flpvsk/glagol/ms20verb.kicad_pcb

## KiCad design ms20verb.kicad_pcb (2021-09-10)

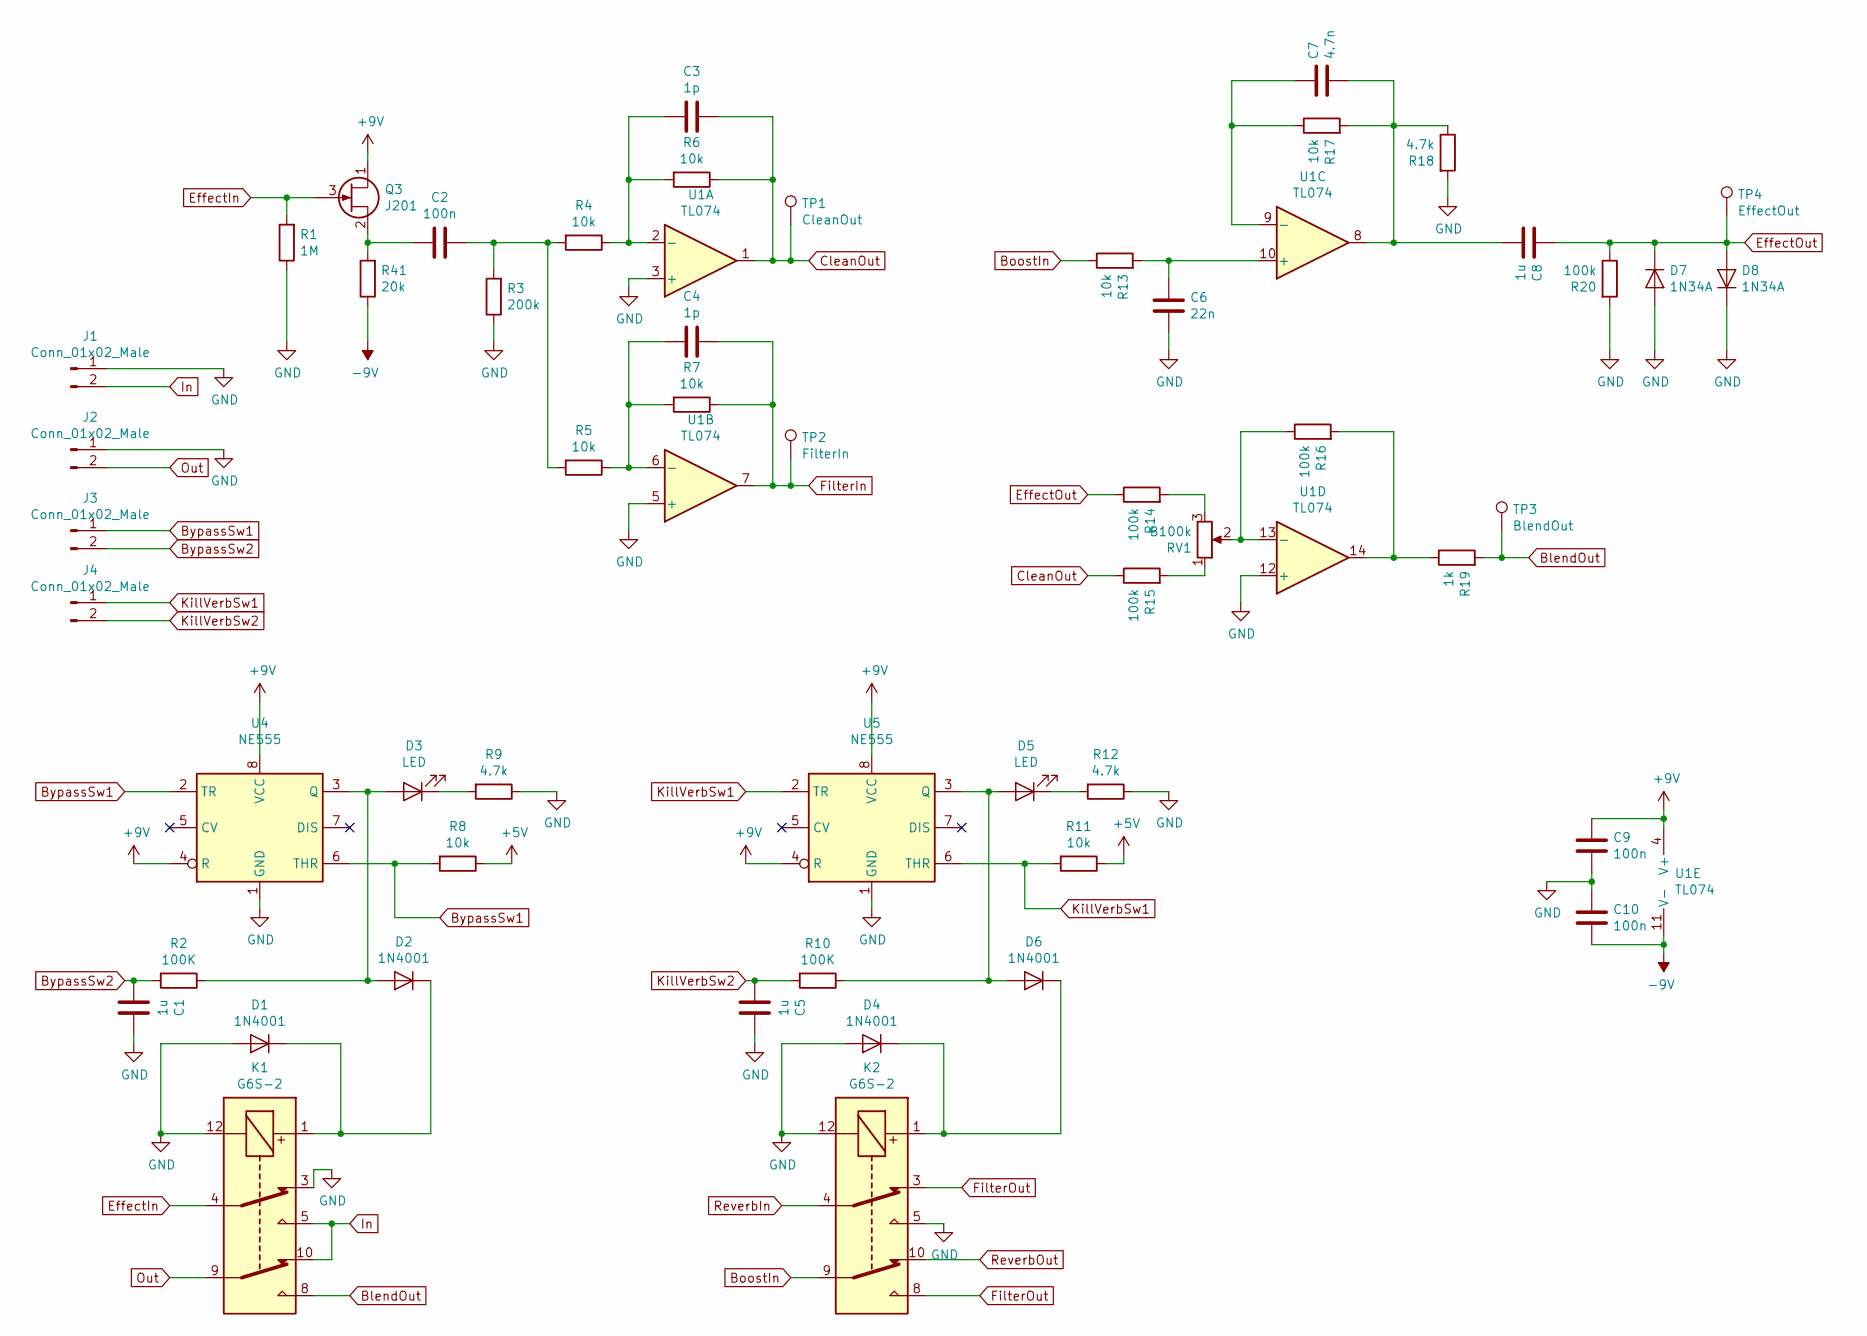
[picture p5: schematic Sheet1.sch, Ping]

Parts:
C1, C5, C8: 1u; C_Rect_L7.0mm_W4.5mm_P5.00mm
C2, C9, C10: 100n; C_Rect_L7.0mm_W2.5mm_P5.00mm
C3, C4: 1p; C_Disc_D4.7mm_W2.5mm_P5.00mm
C6: 22n; C_Disc_D5.1mm_W3.2mm_P5.00mm
C7: 4.7n; C_Disc_D5.1mm_W3.2mm_P5.00mm
D1, D2, D4, D6: 1N4001; D_DO-41_SOD81_P10.16mm_Horizontal
D3, D5: LED; LED_D5.0mm
D7, D8: 1N34A; D_DO-41_SOD81_P10.16mm_Horizontal
J1, J2, J3, J4: Conn_01x02_Male; JST_XH_B2B-XH-A_1x02_P2.50mm_Vertical
K1, K2: G6S-2; 8-PIN_Fujitsu_Tayda
Q3: J201; TO-92L_Inline_Wide
R1: 1M; R_0603_1608Metric_Pad1.05x0.95mm_HandSolder
R2, R10: 100K; R_0603_1608Metric_Pad1.05x0.95mm_HandSolder
R3: 200k; R_0603_1608Metric_Pad1.05x0.95mm_HandSolder
R4, R5, R6, R7, R8, R11, R13, R17: 10k; R_0603_1608Metric_Pad1.05x0.95mm_HandSolder
R9, R12, R18: 4.7k; R_0603_1608Metric_Pad1.05x0.95mm_HandSolder
R14, R15, R16, R20: 100k; R_0603_1608Metric_Pad1.05x0.95mm_HandSolder
R19: 1k; R_0603_1608Metric_Pad1.05x0.95mm_HandSolder
R41: 20k; R_0603_1608Metric_Pad1.05x0.95mm_HandSolder
RV1: B100k; 16MM_B.MOUNT_BANZAI
TP1: CleanOut; TestPoint_THTPad_D1.5mm_Drill0.7mm
TP2: FilterIn; TestPoint_THTPad_D1.5mm_Drill0.7mm
TP3: BlendOut; TestPoint_THTPad_D1.5mm_Drill0.7mm
TP4: EffectOut; TestPoint_THTPad_D1.5mm_Drill0.7mm
U1: TL074; DIP-14_W7.62mm
U4, U5: NE555; DIP-8_W7.62mm

Connections:
+5V: R8.1, R11.1; also elsewhere on the board
+9V: C9.1, Q3.1 (D), U1.4 (V+), U4.4 (R), U4.8 (VCC), U5.4 (R), U5.8 (VCC); also elsewhere on the board
-9V: C10.2, R41.1, U1.11 (V-); also elsewhere on the board
BlendOut: K1.8, R19.2, TP3.1
BoostIn: K2.9, R13.1
BypassSw1: J3.1, R8.2, U4.2 (TR), U4.6 (THR)
BypassSw2: C1.2, J3.2, R2.2
CleanOut: C3.1, R6.1, R15.1, TP1.1, U1.1
EffectIn: K1.4, Q3.3 (G), R1.2
EffectOut: C8.2, D7.1 (K), D8.2 (A), R14.1, R20.1, TP4.1
FilterIn: C4.1, R7.1, TP2.1, U1.7; also elsewhere on the board
FilterOut: K2.3, K2.8; also elsewhere on the board
GND: C1.1, C5.1, C6.1, C9.2, C10.1, D1.2 (A), D4.2 (A), D7.2 (A), D8.1 (K), J1.1, J2.1, K1.3, K1.12, K2.5, K2.12, R1.1, R3.1, R9.1, R12.1, R18.2, R20.2, U1.3 (+), U1.5 (+), U1.12 (+), U4.1 (GND), U5.1 (GND); also elsewhere on the board
In: J1.2, K1.5, K1.10
KillVerbSw1: J4.1, R11.2, U5.2 (TR), U5.6 (THR)
KillVerbSw2: C5.2, J4.2, R10.2
unnamed: C2.1, R3.2, R4.2, R5.2
unnamed: C2.2, Q3.2 (S), R41.2
unnamed: C3.2, R4.1, R6.2, U1.2 (-)
unnamed: C4.2, R5.1, R7.2, U1.6 (-)
unnamed: C6.2, R13.2, U1.10 (+)
unnamed: C7.1, C8.1, R17.2, R18.1, U1.8
unnamed: C7.2, R17.1, U1.9 (-)
unnamed: D1.1 (K), D2.1 (K), K1.1
unnamed: D2.2 (A), D3.2 (A), R2.1, U4.3 (Q)
unnamed: D3.1 (K), R9.2
unnamed: D4.1 (K), D6.1 (K), K2.1
unnamed: D5.1 (K), R12.2
unnamed: D5.2 (A), D6.2 (A), R10.1, U5.3 (Q)
unnamed: R14.2, RV1.3
unnamed: R15.2, RV1.1
unnamed: R16.1, RV1.2, U1.13 (-)
unnamed: R16.2, R19.1, U1.14
Out: J2.2, K1.9
ReverbIn: K2.4; also elsewhere on the board
ReverbOut: K2.10; also elsewhere on the board

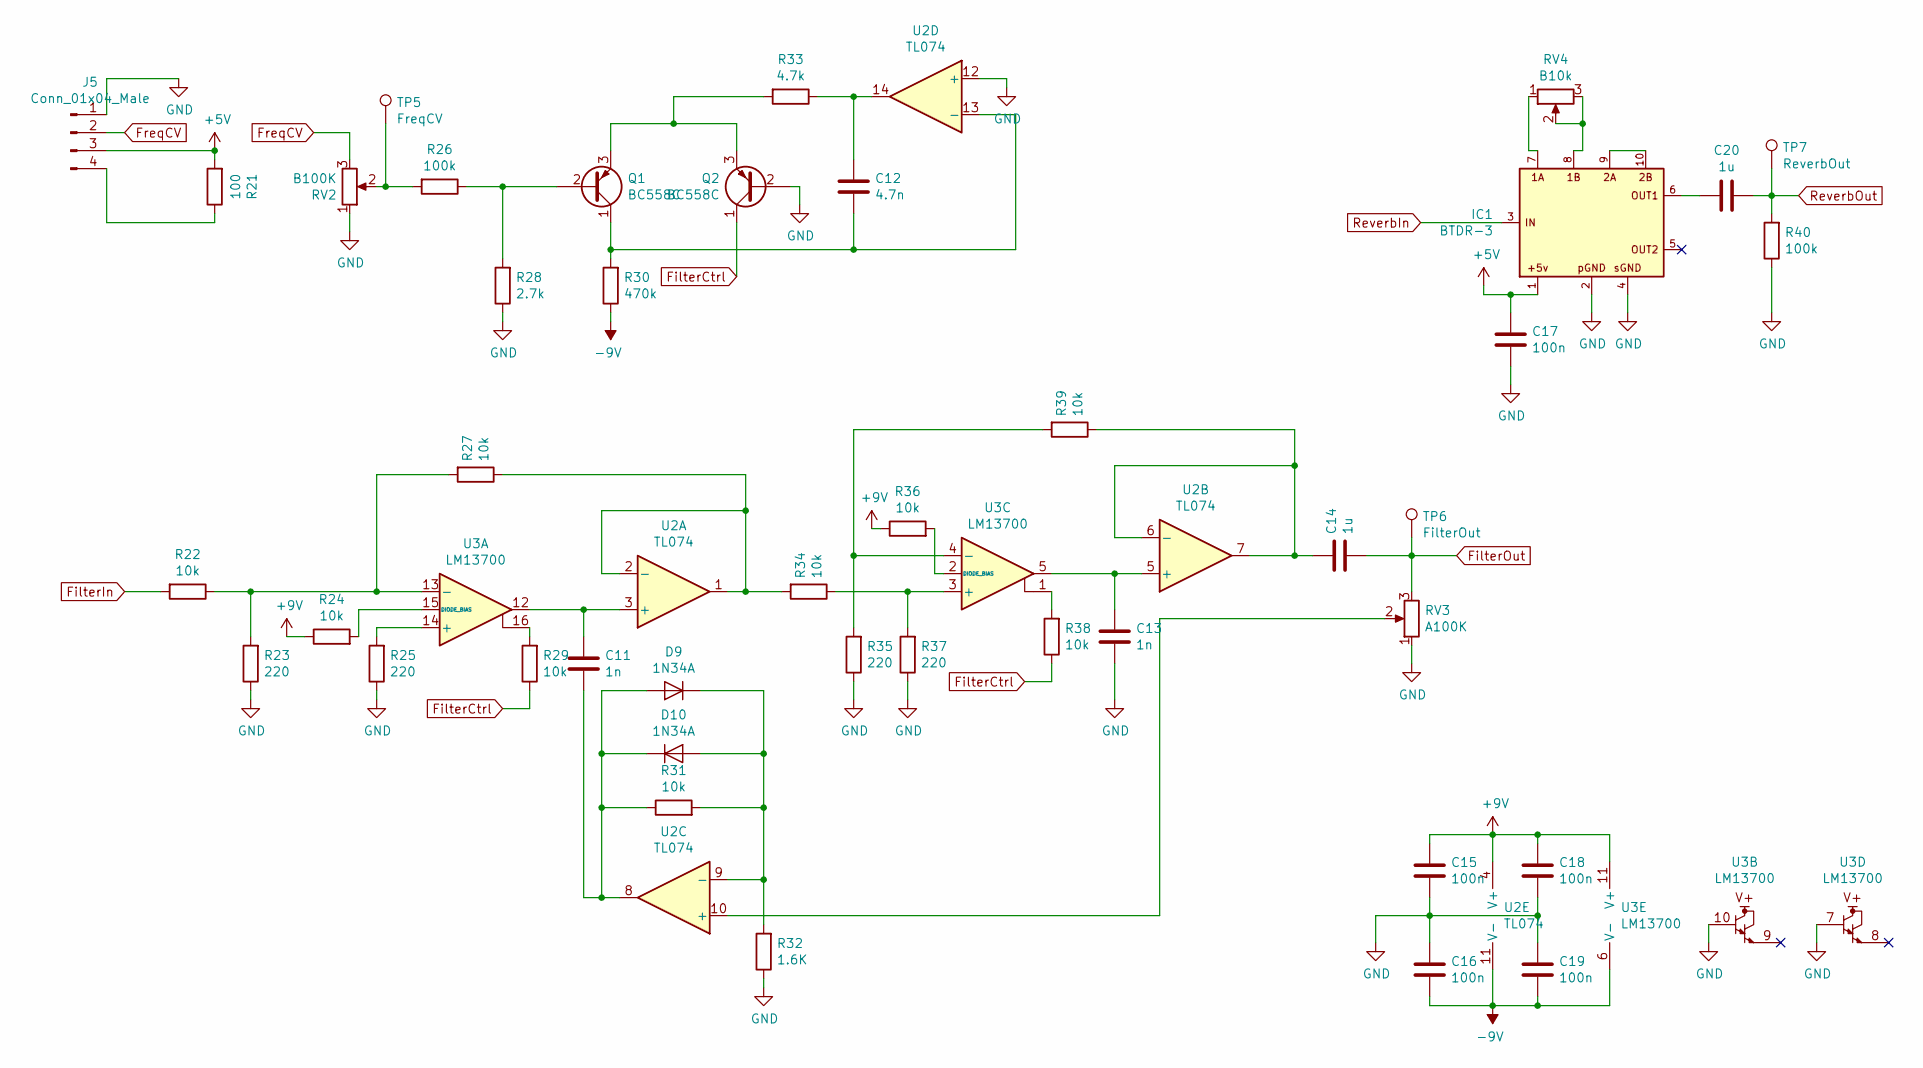
[picture p6: schematic Sheet2.sch, Ping]

Parts:
C11, C13: 1n; C_Disc_D5.1mm_W3.2mm_P5.00mm
C12: 4.7n; C_Disc_D5.1mm_W3.2mm_P5.00mm
C14, C20: 1u; C_Rect_L7.0mm_W4.5mm_P5.00mm
C15, C16, C17, C18, C19: 100n; C_Rect_L7.0mm_W2.5mm_P5.00mm
D9, D10: 1N34A; D_DO-41_SOD81_P10.16mm_Horizontal
IC1: BTDR-3
J5: Conn_01x04_Male; JST_XH_B4B-XH-A_1x04_P2.50mm_Vertical
Q1, Q2: BC558C; TO-92L_Inline_Wide
R21: 100; R_0603_1608Metric_Pad1.05x0.95mm_HandSolder
R22, R24, R27, R29, R31, R34, R36, R38, R39: 10k; R_0603_1608Metric_Pad1.05x0.95mm_HandSolder
R23, R25, R35, R37: 220; R_0603_1608Metric_Pad1.05x0.95mm_HandSolder
R26, R40: 100k; R_0603_1608Metric_Pad1.05x0.95mm_HandSolder
R28: 2.7k; R_0603_1608Metric_Pad1.05x0.95mm_HandSolder
R30: 470k; R_0603_1608Metric_Pad1.05x0.95mm_HandSolder
R32: 1.6K; R_0603_1608Metric_Pad1.05x0.95mm_HandSolder
R33: 4.7k; R_0603_1608Metric_Pad1.05x0.95mm_HandSolder
RV2: B100K; 16MM_B.MOUNT_BANZAI
RV3: A100K; 16MM_B.MOUNT_BANZAI
RV4: B10k; 16MM_B.MOUNT_BANZAI
TP5: FreqCV; TestPoint_THTPad_D1.5mm_Drill0.7mm
TP6: FilterOut; TestPoint_THTPad_D1.5mm_Drill0.7mm
TP7: ReverbOut; TestPoint_THTPad_D1.5mm_Drill0.7mm
U2: TL074; DIP-14_W7.62mm
U3: LM13700; DIP-16_W7.62mm

Connections:
+5V: C17.1, IC1.1, J5.3, R21.2; also elsewhere on the board
+9V: C15.1, C18.1, R24.1, R36.1, U2.4 (V+), U3.11 (V+); also elsewhere on the board
-9V: C16.2, C19.2, R30.1, U2.11 (V-), U3.6 (V-); also elsewhere on the board
FilterCtrl: Q2.1 (C), R29.1, R38.1
FilterIn: R22.2; also elsewhere on the board
FilterOut: C14.1, RV3.3, TP6.1; also elsewhere on the board
FreqCV: J5.2, RV2.3
GND: C13.1, C15.2, C16.1, C17.2, C18.2, C19.1, IC1.2, IC1.4, J5.1, Q2.2 (B), R23.1, R25.1, R28.1, R32.1, R35.1, R37.1, R40.1, RV2.1, RV3.1, U2.12 (+), U3.7, U3.10; also elsewhere on the board
unnamed: C11.1, D9.2 (A), D10.1 (K), R31.1, U2.8
unnamed: C11.2, U2.3 (+), U3.12
unnamed: C12.1, Q1.1 (C), R30.2, U2.13 (-)
unnamed: C12.2, R33.1, U2.14
unnamed: C13.2, U2.5 (+), U3.5
unnamed: C14.2, R39.1, U2.6 (-), U2.7
unnamed: C20.2, IC1.6
unnamed: D9.1 (K), D10.2 (A), R31.2, R32.2, U2.9 (-)
unnamed: IC1.7, RV4.1
unnamed: IC1.8, RV4.2, RV4.3
unnamed: IC1.9, IC1.10
unnamed: J5.4, R21.1
unnamed: Q1.2 (B), R26.1, R28.2
unnamed: Q1.3 (E), Q2.3 (E), R33.2
unnamed: R22.1, R23.2, R27.2, U3.13 (-)
unnamed: R24.2, U3.15 (DIODE_BIAS)
unnamed: R25.2, U3.14 (+)
unnamed: R26.2, RV2.2, TP5.1
unnamed: R27.1, R34.2, U2.1, U2.2 (-)
unnamed: R29.2, U3.16
unnamed: R34.1, R37.2, U3.3 (+)
unnamed: R35.2, R39.2, U3.4 (-)
unnamed: R36.2, U3.2 (DIODE_BIAS)
unnamed: R38.2, U3.1
unnamed: RV3.2, U2.10 (+)
ReverbIn: IC1.3; also elsewhere on the board
ReverbOut: C20.1, R40.2, TP7.1; also elsewhere on the board

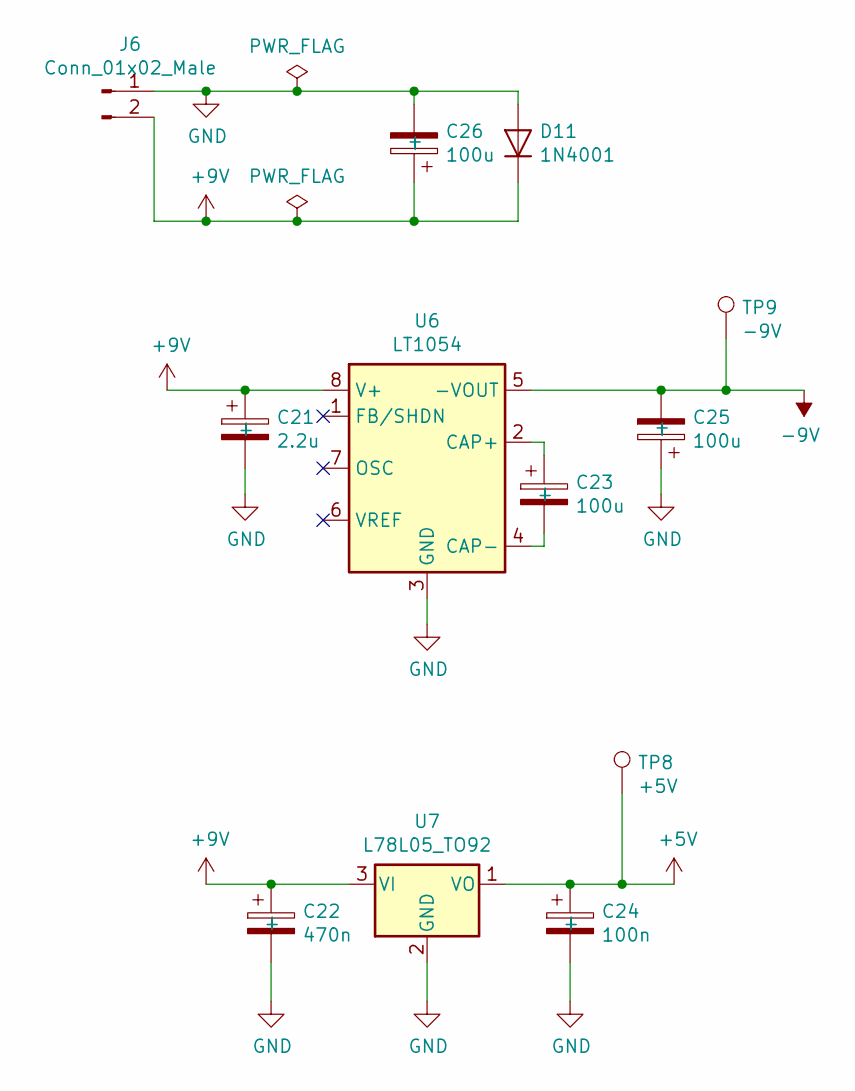
[picture p7: schematic Sheet3.sch, Ping]

Parts:
C21: 2.2u; CP_Radial_D5.0mm_P2.00mm
C22: 470n; CP_Radial_D5.0mm_P2.00mm
C23, C25, C26: 100u; CP_Radial_D5.0mm_P2.50mm
C24: 100n; CP_Radial_D5.0mm_P2.00mm
D11: 1N4001; D_DO-41_SOD81_P10.16mm_Horizontal
J6: Conn_01x02_Male; JST_XH_B2B-XH-A_1x02_P2.50mm_Vertical
TP8: +5V; TestPoint_THTPad_D1.5mm_Drill0.7mm
TP9: -9V; TestPoint_THTPad_D1.5mm_Drill0.7mm
U6: LT1054; DIP-8_W7.62mm
U7: L78L05_TO92; TO-92_Inline

Connections:
+5V: C24.1 (+), TP8.1, U7.1 (VO); also elsewhere on the board
+9V: C21.1 (+), C22.1 (+), C26.1 (+), D11.1 (K), J6.2, U6.8 (V+), U7.3 (VI); also elsewhere on the board
-9V: C25.2 (-), TP9.1, U6.5 (-VOUT); also elsewhere on the board
GND: C21.2 (-), C22.2 (-), C24.2 (-), C25.1 (+), C26.2 (-), D11.2 (A), J6.1, U6.3 (GND), U7.2 (GND); also elsewhere on the board
unnamed: C23.1 (+), U6.2 (CAP+)
unnamed: C23.2 (-), U6.4 (CAP-)

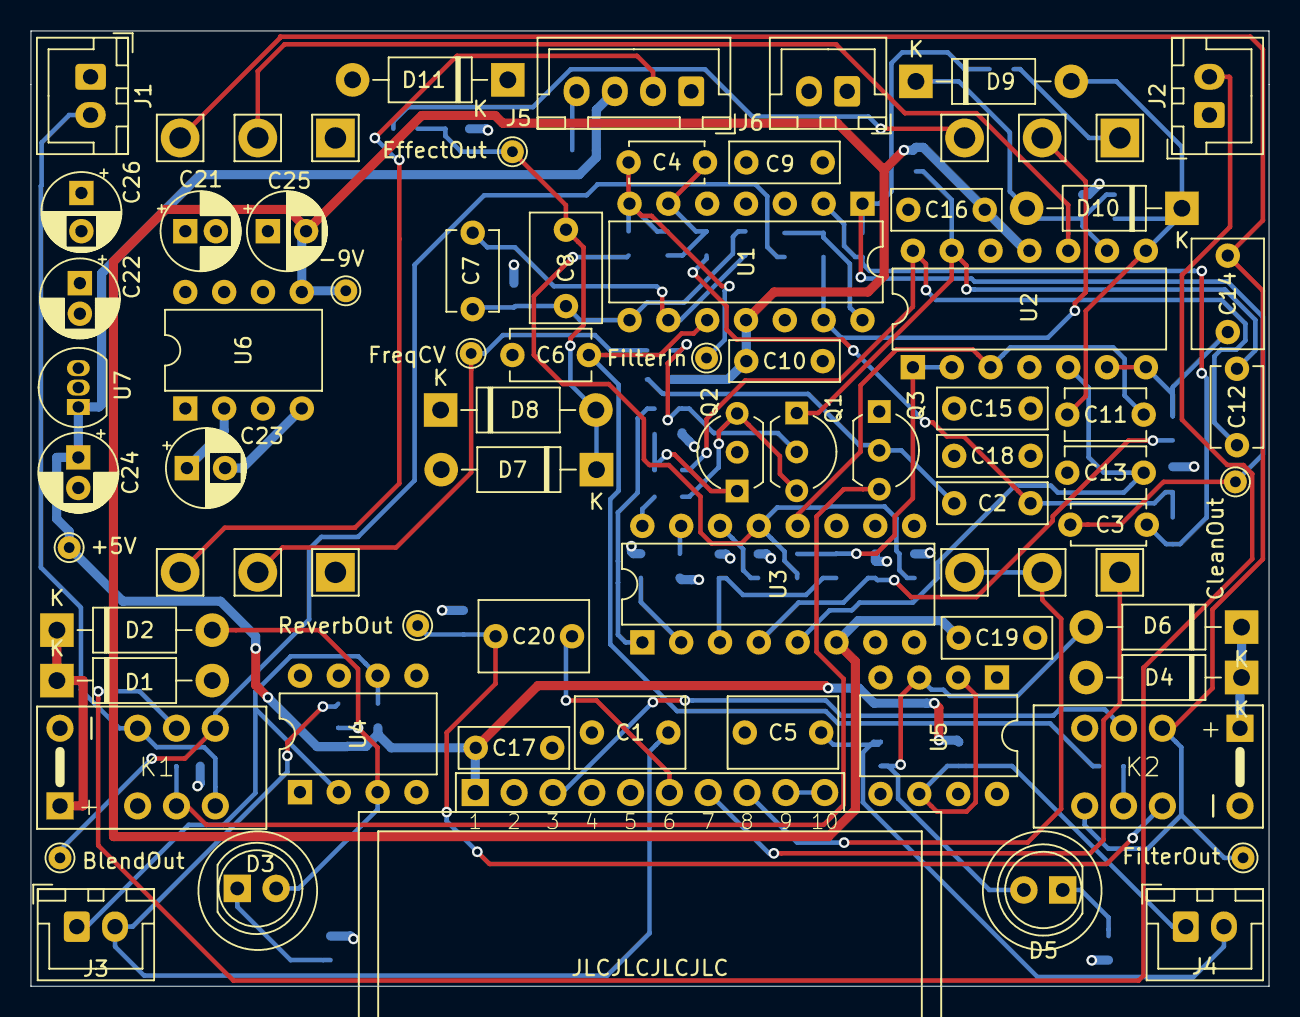
[picture p8: board ms20verb.kicad_pcb from above]

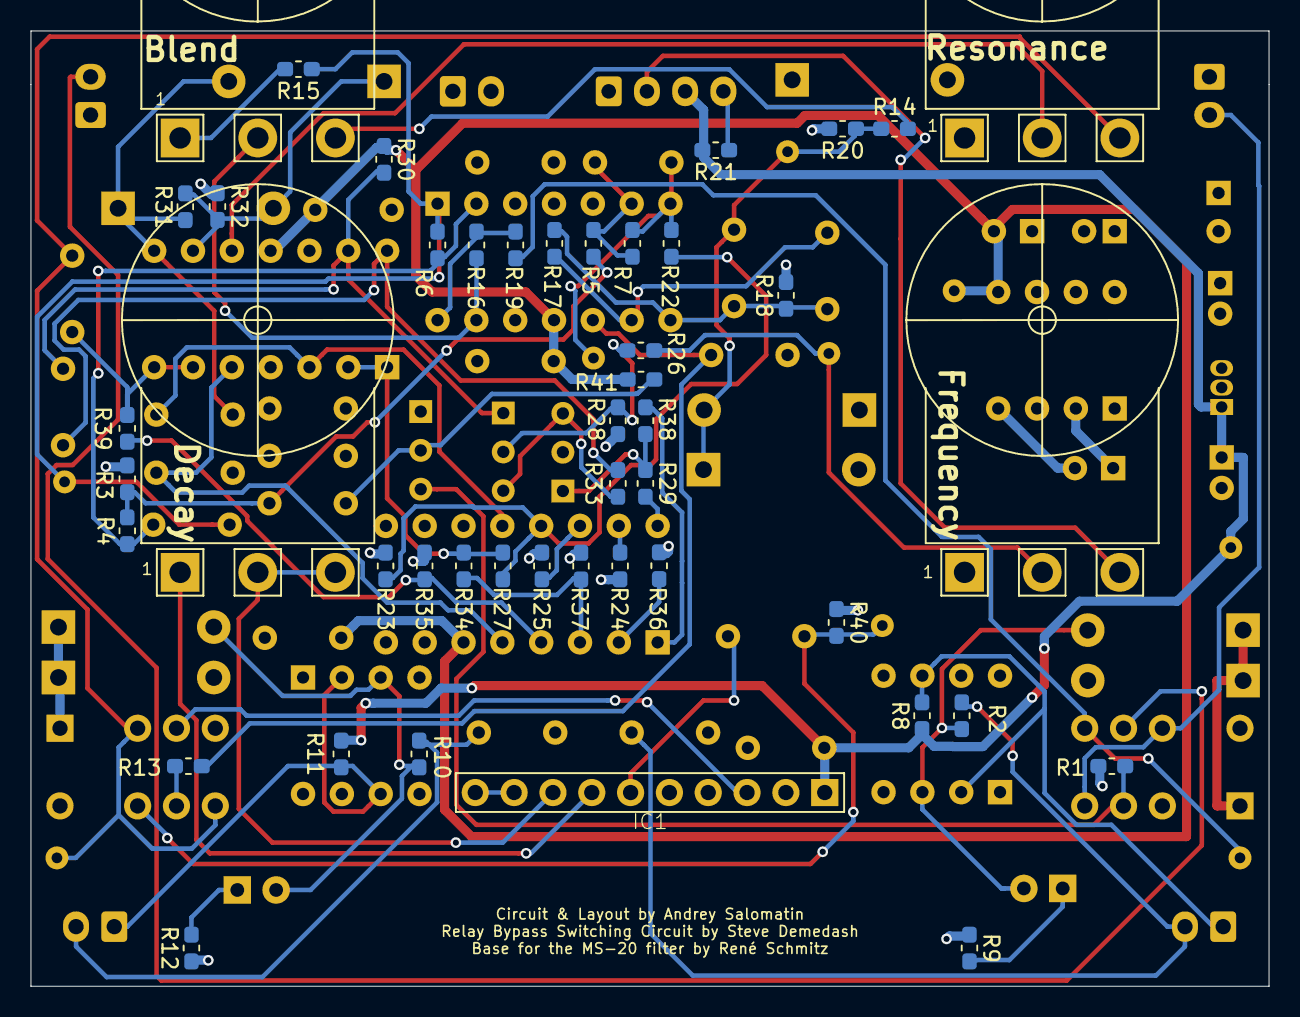
[picture p9: board ms20verb.kicad_pcb from below]

Board: 4 copper layers, 81.0 x 62.5 mm, 113 parts (41 on the bottom side), 65 nets.

Other parts of the board:
Ref**: Val**; MOMENTARY
Ref**#2: Val**; MOMENTARY
Ref**#3: Val**; DC_TOP
