flpvsk/glagol/(commit log)

2021-08-14 TH version
    [Sheet1.sch, Sheet2.sch, Sheet3.sch, ms20verb.kicad_pcb, ms20verb.sch]
2021-08-14 Resistors to SMD
    [Sheet1.sch, Sheet2.sch, ms20verb.kicad_pcb]
2021-08-19 2 layer dead end
    [Sheet1.sch, ms20verb.kicad_pcb]
2021-08-19 4-layer board finished
    [ms20verb.kicad_pcb]
2021-08-22 Hand-solder 0603 resistors
    [ms20verb.kicad_pcb]
2021-09-10 v1 sent to JLC
    [Sheet1.sch, Sheet2.sch, Sheet3.sch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]
